M0WUT/p0004-pcb-001_lcd-board/README.md

# P0004-PCB-001 - LCD Board
Front panel board featuring MCU and LCD
