M0WUT/p0004-pcb-001_lcd-board/Schematics/README.md

Use for schematic files other than the top level sheet
