M0WUT/p0004-pcb-001_lcd-board/P0004-PCB-001.kicad_pcb

## KiCad design P0004-PCB-001.kicad_pcb (2026-07-19)

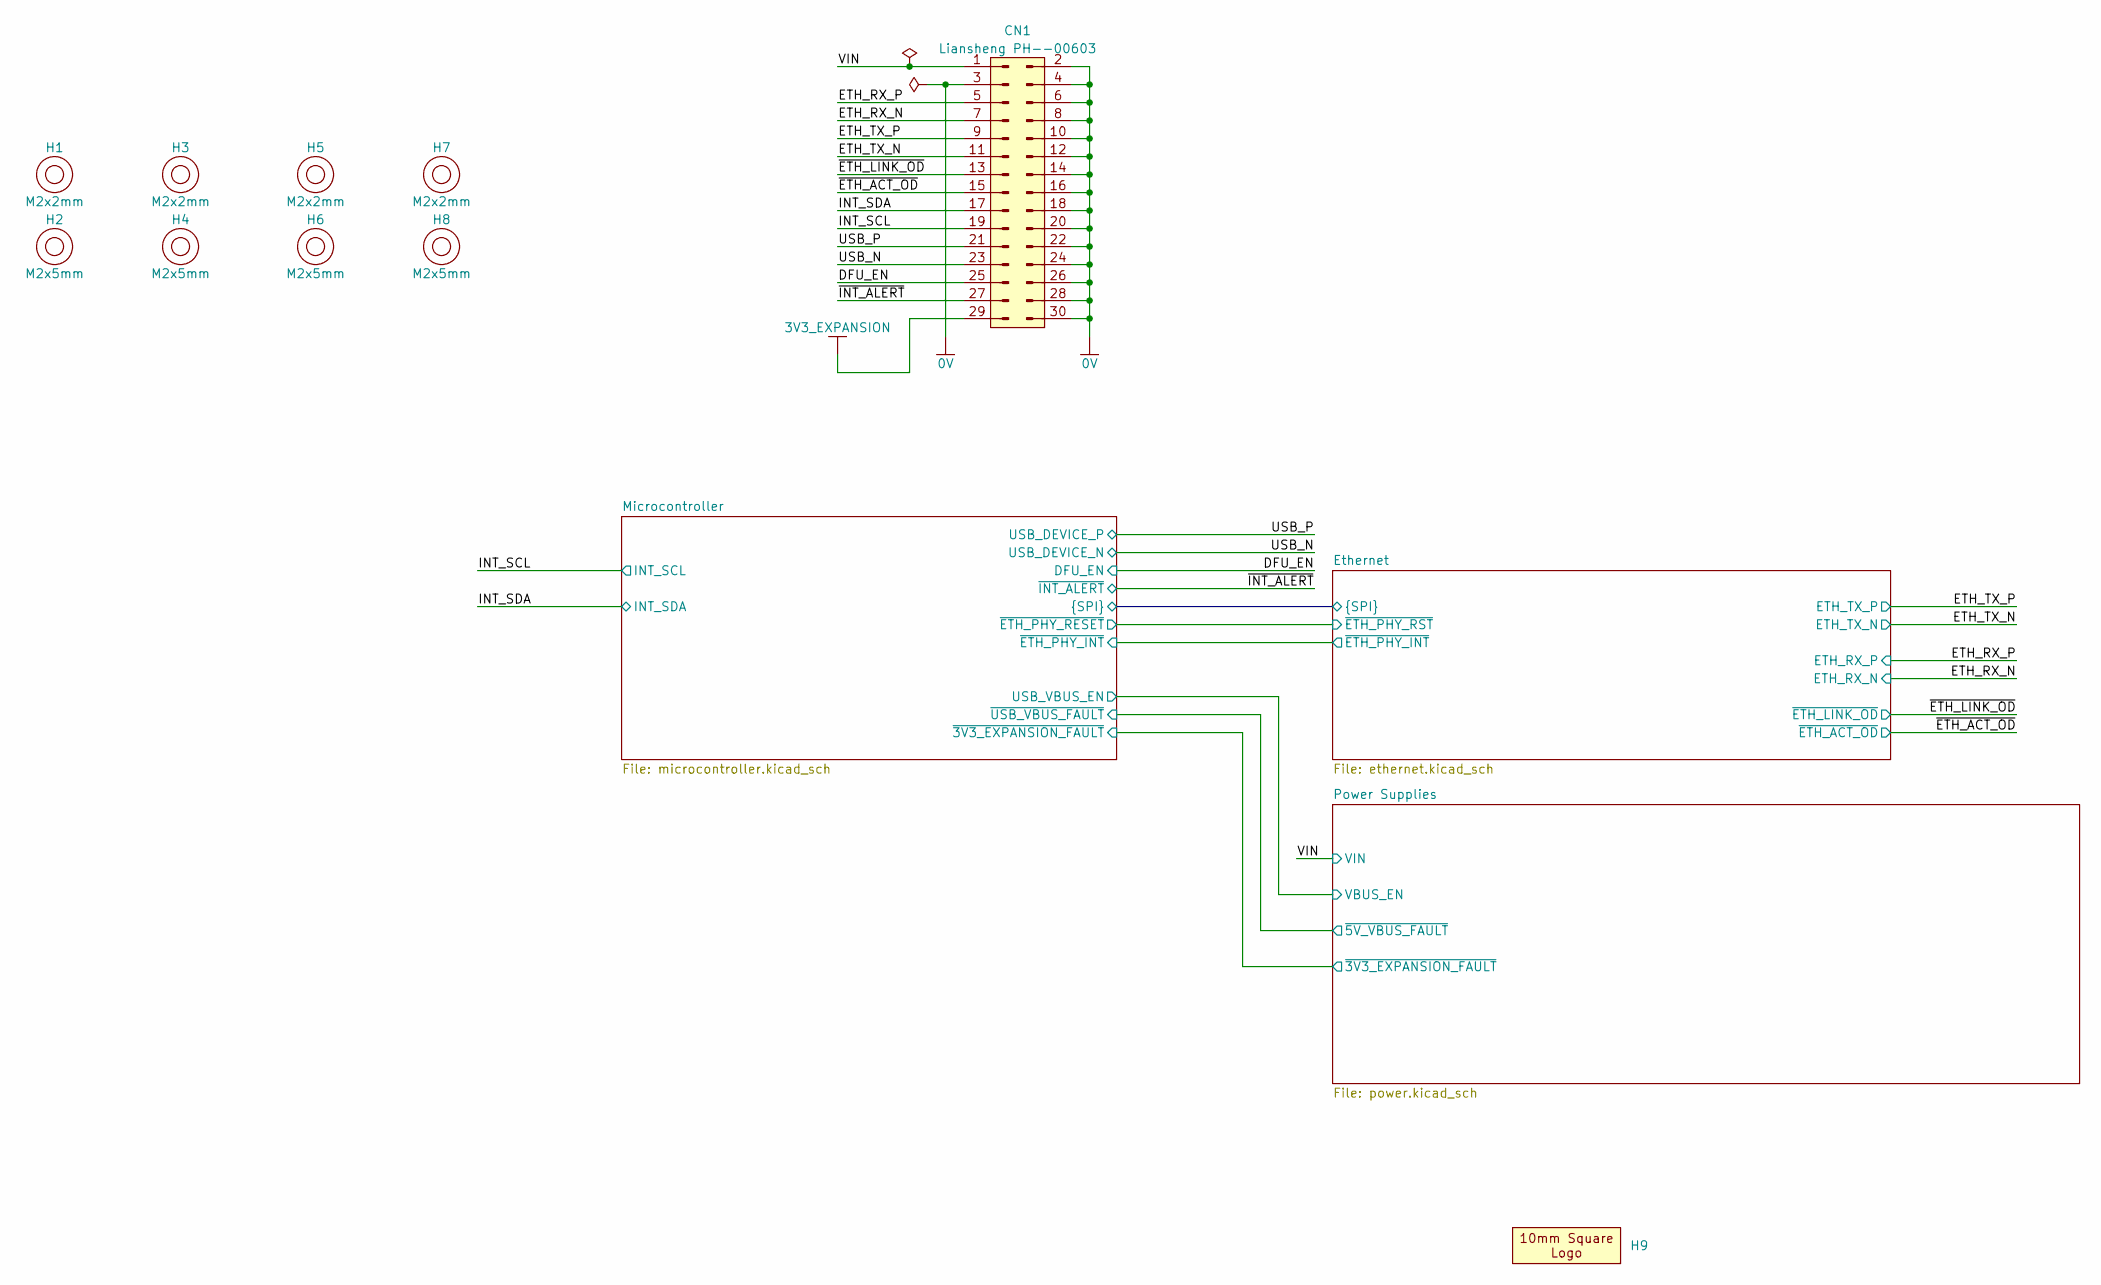
[picture p1: schematic P0004-PCB-001.kicad_sch]

Parts:
CN1: Liansheng PH--00603; Liansheng_PH--00603; MPN PH--00603; JLC Part Number C2685170
H1, H3, H5, H7: M2x2mm; Accu_HPS-4-2.2-2-POM-BL; MPN HPS-4-2.2-2-POM-BL
H2, H4, H6, H8: M2x5mm; Accu_HPS-4-2.2-5-POM-BL; MPN HPS-4-2.2-2-POM-BL
H9: Logo_10mmx10mm

Connections:
0V: CN1.2 (Pin_1), CN1.3, CN1.4, CN1.6, CN1.8, CN1.10, CN1.12, CN1.14, CN1.16, CN1.18, CN1.20, CN1.22, CN1.24, CN1.26, CN1.28, CN1.30; also elsewhere on the board
3V3_EXPANSION: CN1.29; also elsewhere on the board
/DFU_EN: CN1.25; also elsewhere on the board
/ETH_RX_N: CN1.7; also elsewhere on the board
/ETH_RX_P: CN1.5; also elsewhere on the board
/ETH_TX_N: CN1.11; also elsewhere on the board
/ETH_TX_P: CN1.9; also elsewhere on the board
/INT_SCL: CN1.19; also elsewhere on the board
/INT_SDA: CN1.17; also elsewhere on the board
/USB_N: CN1.23; also elsewhere on the board
/USB_P: CN1.21; also elsewhere on the board
/VIN: CN1.1; also elsewhere on the board
/~ETH_ACT_OD: CN1.15; also elsewhere on the board
/~ETH_LINK_OD: CN1.13; also elsewhere on the board
/~INT_ALERT: CN1.27; also elsewhere on the board

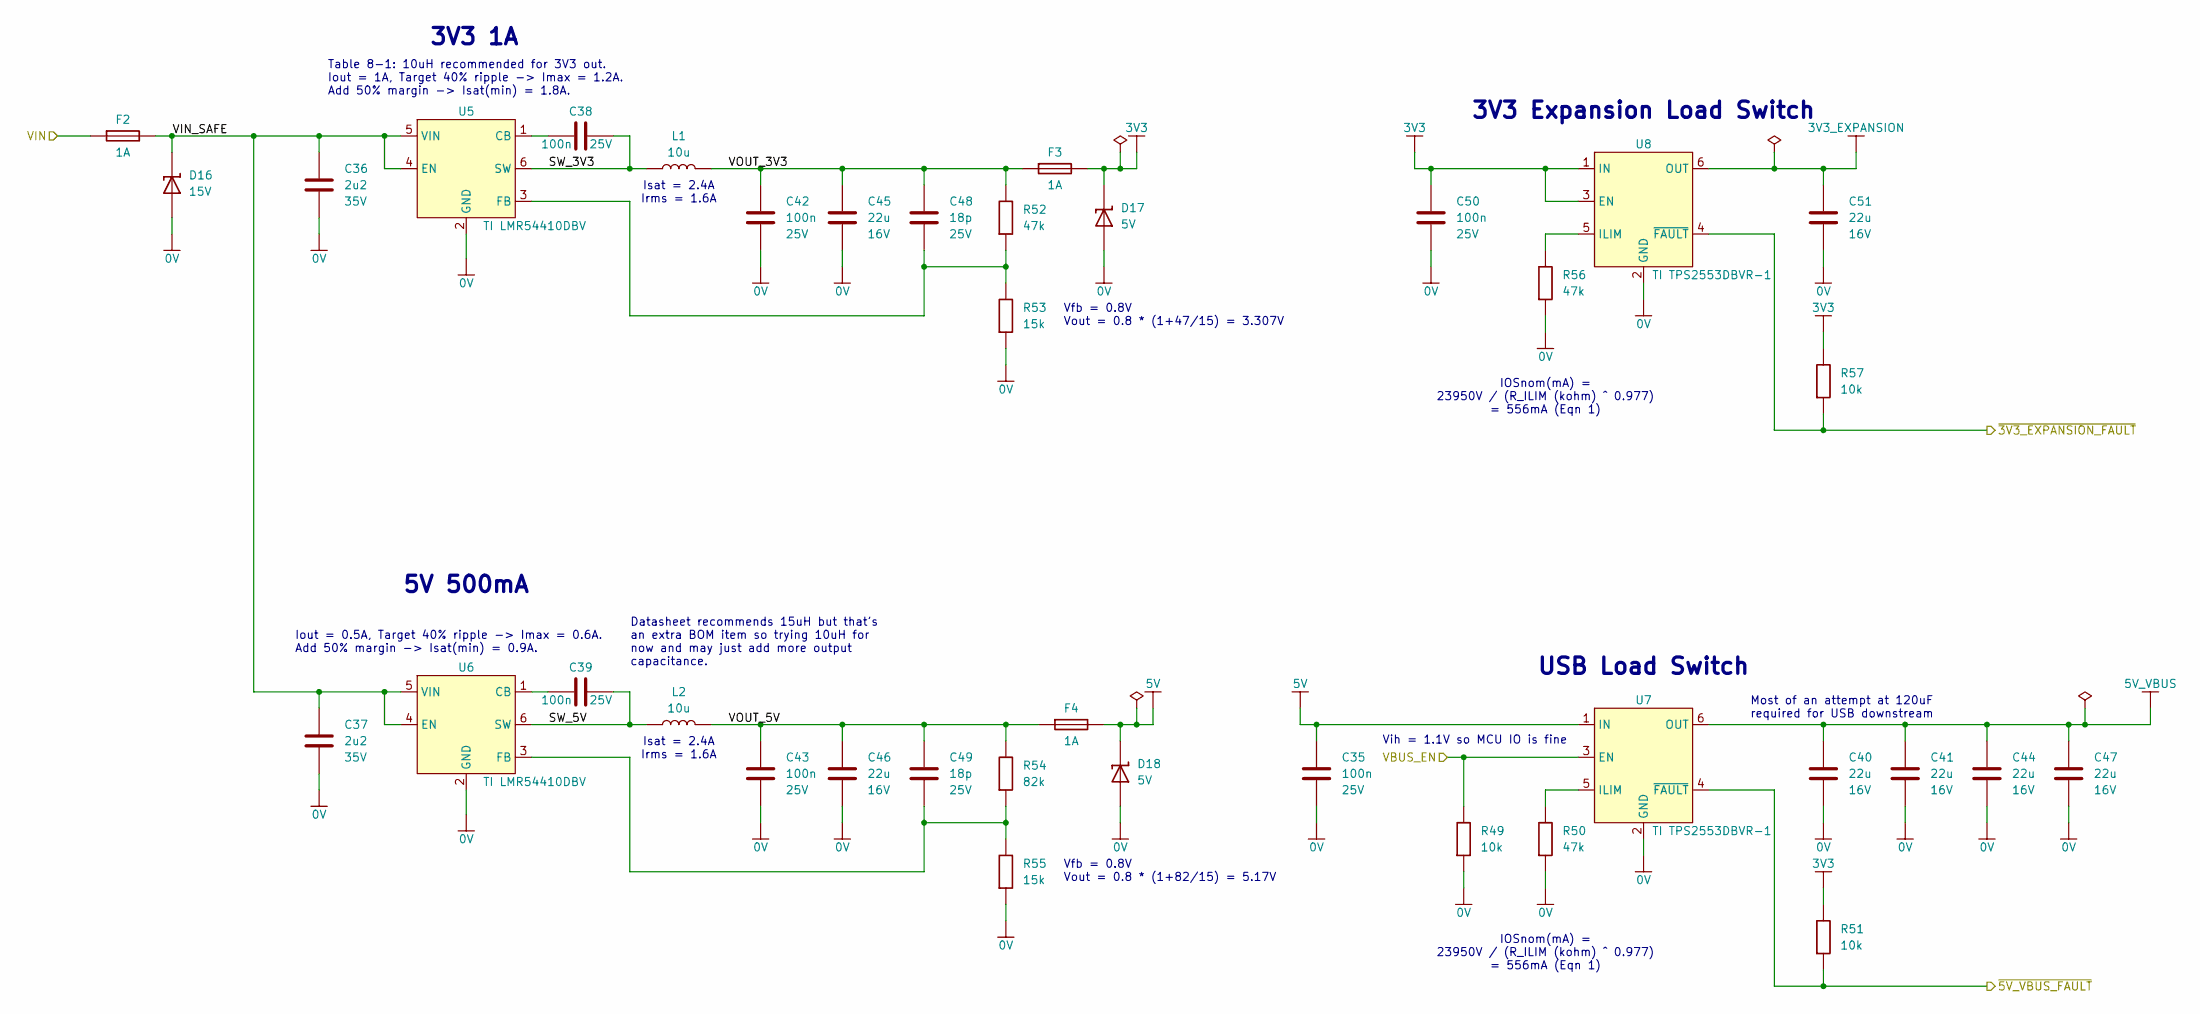
[picture p2: schematic power.kicad_sch]

Parts:
C35, C38, C39, C42, C43, C50: 100n; C_0402_1005Metric; Voltage 25V; Tolerance 10%; MPN CC0402KRX7R8BB104
C36, C37: 2u2; C_0402_1005Metric; Voltage 35V; Tolerance 10%; MPN GRM155R6YA225KE11
C40, C41, C44, C45, C46, C47, C51: 22u; C_0603_1608Metric; Voltage 16V; Tolerance 20%; MPN GRM188R61C226ME01
C48, C49: 18p; C_0402_1005Metric; Voltage 25V; Tolerance 10%; MPN C0402C180K3GACTU
D16: 15V; D_SOD-323; MPN CDSOD-323-T15S
D17, D18: 5V; D_SOD-523; MPN H5VND5U
F2, F3, F4: 1A; Fuse_0603_1608Metric; MPN 0467001.NR
L1, L2: 10u; APV_ANR4030; Tolerance 20%; MPN ANR4030T100M
R49, R51, R57: 10k; R_0402_1005Metric; Tolerance 1%; MPN RK73H1ETTP1002F
R50, R52, R56: 47k; R_0402_1005Metric; Tolerance 1%; MPN RK73H1ETTP4702F
R53, R55: 15k; R_0402_1005Metric; Tolerance 1%; MPN RK73H1ETTP1502F
R54: 82k; R_0402_1005Metric; Tolerance 1%; MPN RK73H1ETTP8202F
U5, U6: TI LMR54410DBV; SOT-23-6; MPN LMR54410DBV; JLCPCB Order # C3200265
U7, U8: TI TPS2553DBVR-1; SOT-23-6; MPN TPS2553DBVR-1; JLCPCB Order # C55266

Connections:
0V: C35.2, C36.2, C37.2, C40.2, C41.2, C42.2, C43.2, C44.2, C45.2, C46.2, C47.2, C50.2, C51.2, D16.2 (A), D17.2 (A), D18.2 (A), R49.2, R50.2, R53.2, R55.2, R56.2, U5.2 (GND), U6.2 (GND), U7.2 (GND), U8.2 (GND); also elsewhere on the board
3V3: C50.1, D17.1 (K), F3.2, R51.1, R57.1, U8.1 (IN), U8.3 (EN); also elsewhere on the board
3V3_EXPANSION: C51.1, U8.6 (OUT); also elsewhere on the board
5V: C35.1, D18.1 (K), F4.2, U7.1 (IN)
5V_VBUS: C40.1, C41.1, C44.1, C47.1, U7.6 (OUT); also elsewhere on the board
/Microcontroller/USB_VBUS_EN: R49.1, U7.3 (EN); also elsewhere on the board
/Microcontroller/~3V3_EXPANSION_FAULT: R57.2, U8.4 (~FAULT); also elsewhere on the board
/Microcontroller/~USB_VBUS_FAULT: R51.2, U7.4 (~FAULT); also elsewhere on the board
/Power Supplies/SW_3V3: C38.1, L1.1, U5.6 (SW)
/Power Supplies/SW_5V: C39.1, L2.1, U6.6 (SW)
/Power Supplies/VIN_SAFE: C36.1, C37.1, D16.1 (K), F2.2, U5.4 (EN), U5.5 (VIN), U6.4 (EN), U6.5 (VIN)
/Power Supplies/VOUT_3V3: C42.1, C45.1, C48.1, F3.1, L1.2, R52.1
/Power Supplies/VOUT_5V: C43.1, C46.1, C49.1, F4.1, L2.2, R54.1
/VIN: F2.1; also elsewhere on the board
unnamed: C38.2, U5.1 (CB)
unnamed: C48.2, R52.2, R53.1, U5.3 (FB)
unnamed: C39.2, U6.1 (CB)
unnamed: C49.2, R54.2, R55.1, U6.3 (FB)
unnamed: R50.1, U7.5 (ILIM)
unnamed: R56.1, U8.5 (ILIM)

Notes on the sheet:
3V3 1A
Isat = 2.4A Irms = 1.6A
IOSnom(mA) = 23950V / (R_ILIM (kohm) ^ 0.977) = 556mA (Eqn 1)
Vfb = 0.8V Vout = 0.8 * (1+82/15) = 5.17V
Vih = 1.1V so MCU IO is fine
Table 8-1: 10uH recommended for 3V3 out. Iout = 1A, Target 40% ripple -> Imax = 1.2A. Add 50% margin -> Isat(min) = 1.8A.
USB Load Switch
Most of an attempt at 120uF required for USB downstream
3V3 Expansion Load Switch
Vfb = 0.8V Vout = 0.8 * (1+47/15) = 3.307V
5V 500mA
Datasheet recommends 15uH but that's an extra BOM item so trying 10uH for now and may just add more output capacitance.
Iout = 0.5A, Target 40% ripple -> Imax = 0.6A. Add 50% margin -> Isat(min) = 0.9A.

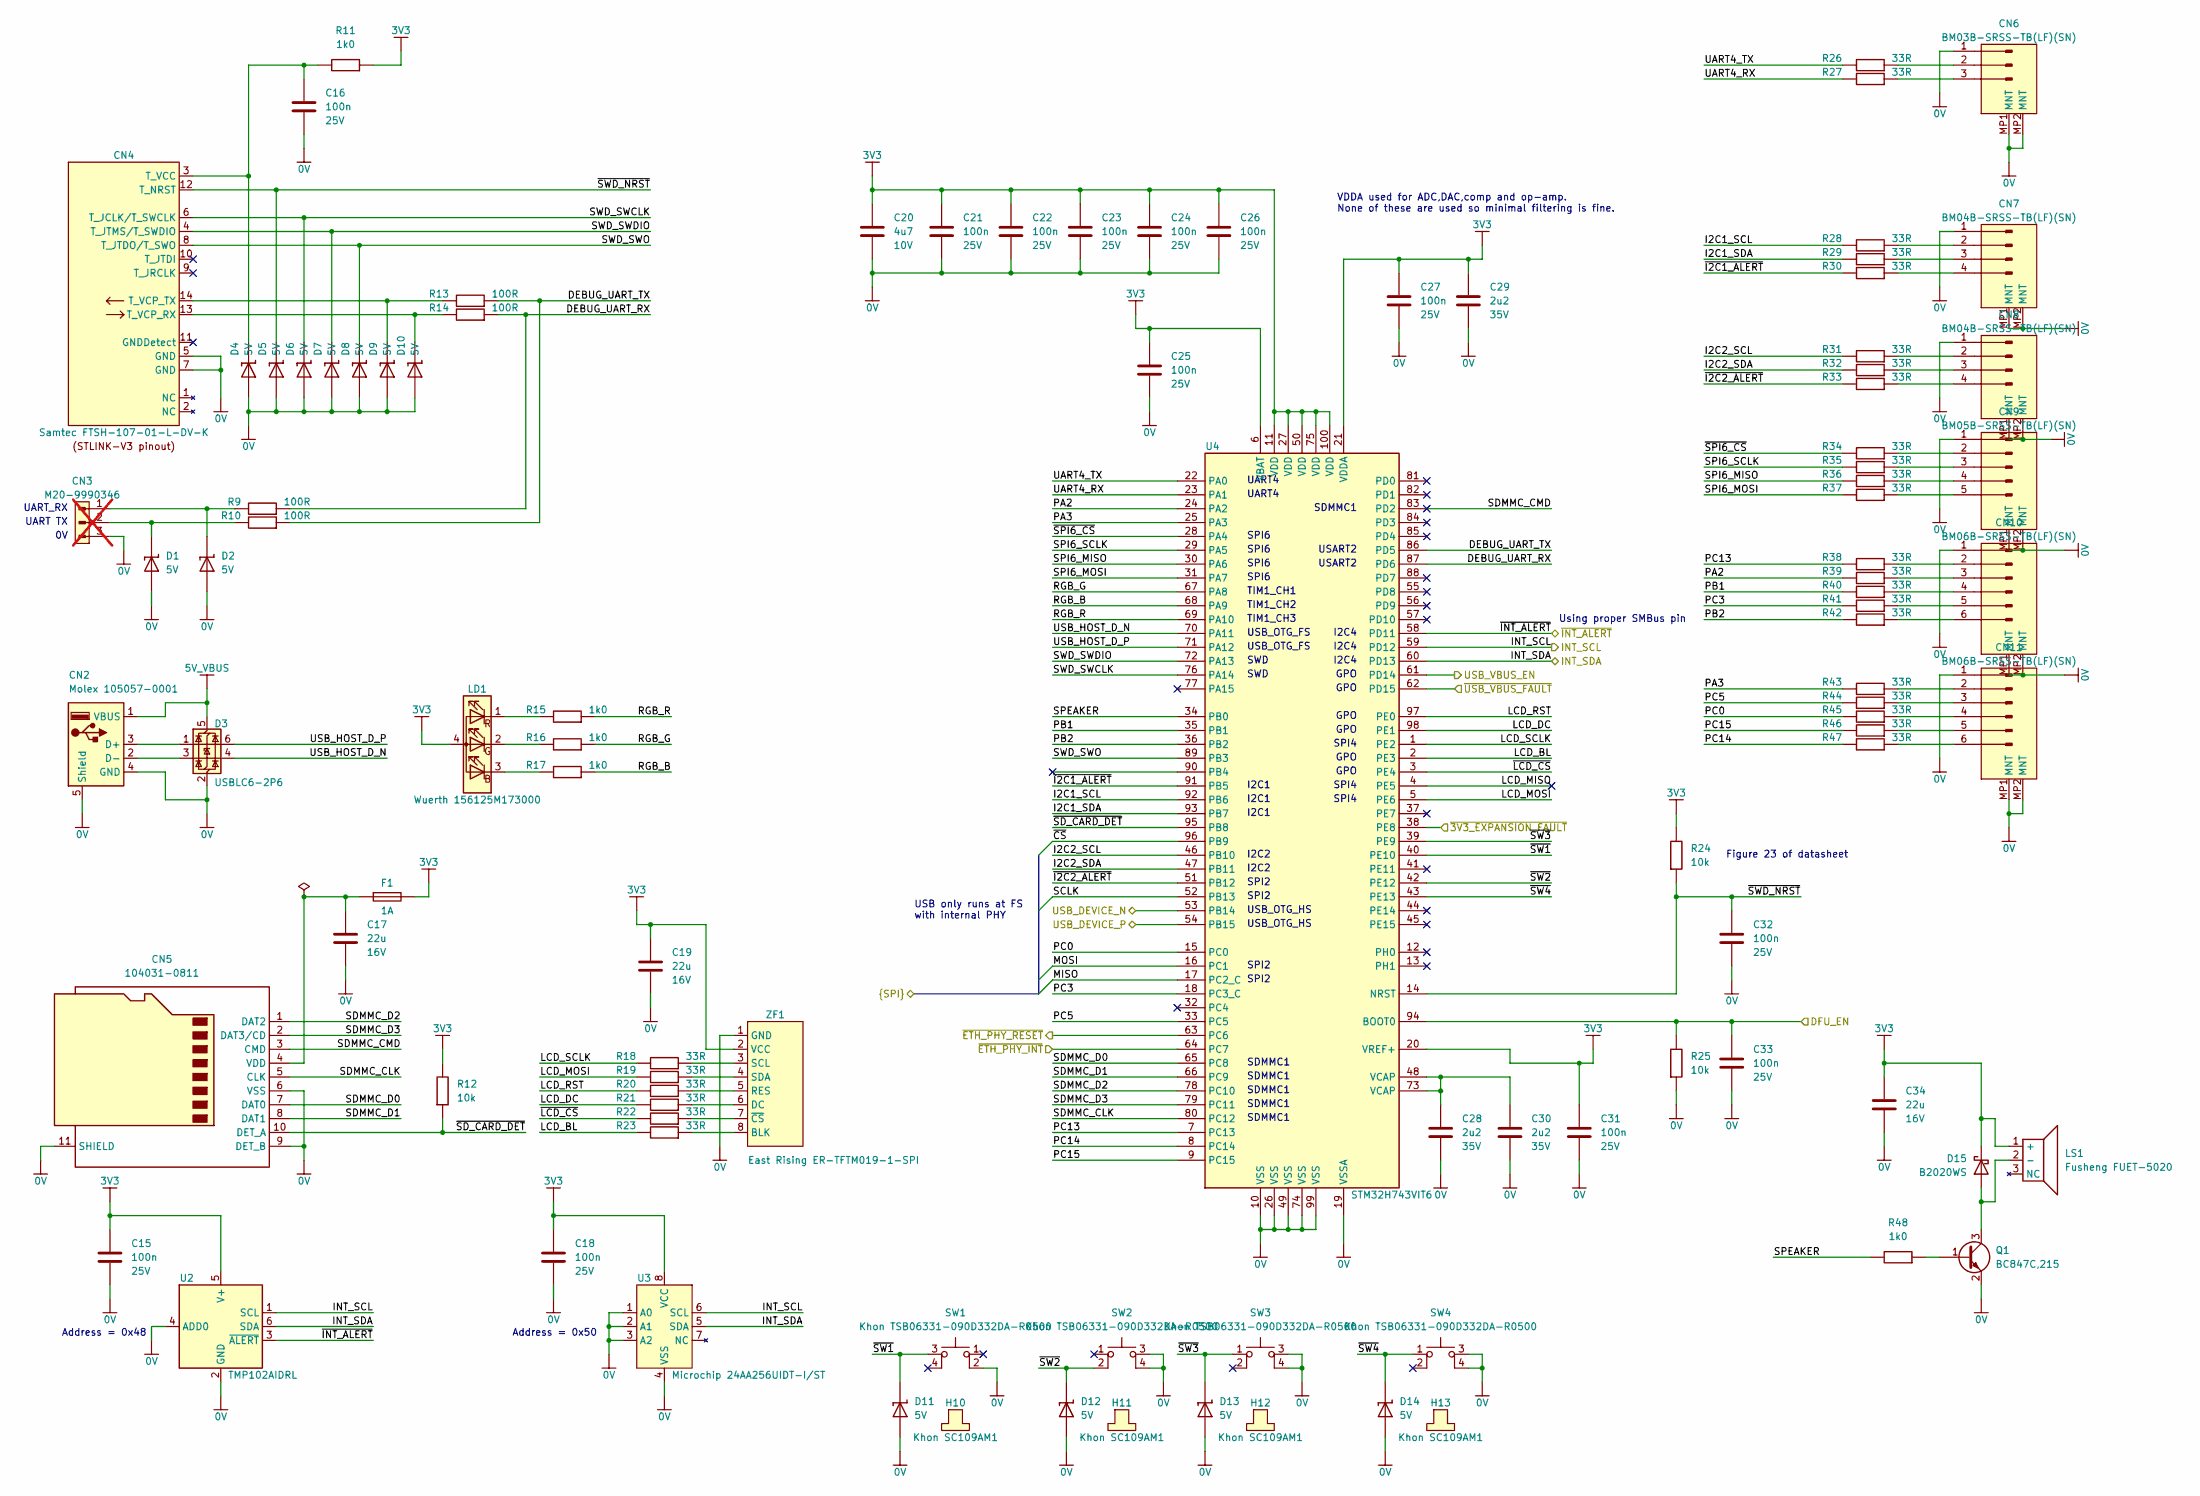
[picture p3: schematic microcontroller.kicad_sch]

Parts:
C15, C16, C18, C21, C22, C23, C24, C25, C26, C27, C31, C32, C33: 100n; C_0402_1005Metric; Voltage 25V; Tolerance 10%; MPN CC0402KRX7R8BB104
C17, C19, C34: 22u; C_0603_1608Metric; Voltage 16V; Tolerance 20%; MPN GRM188R61C226ME01
C20: 4u7; C_0402_1005Metric; Voltage 10V; Tolerance 20%; MPN GRM155D71A475ME15
C28, C29, C30: 2u2; C_0402_1005Metric; Voltage 35V; Tolerance 10%; MPN GRM155R6YA225KE11
CN2: Molex 105057-0001; USB-A_Molex_105057-0001_TH_Vertical; MPN 105057-0001
CN3: M20-9990346; MPN M20-9990346; JLCPCB Order # C5355646; not fitted
CN4: Samtec FTSH-107-01-L-DV-K; Header_Samtec_FTSH-107-01-L-DV-K; MPN FTSH-107-01-L-DV-K; JLCPCB Order # C5307809
CN5: 104031-0811; microSD_HC_Molex_104031-0811; MPN 104031-0811
CN6: BM03B-SRSS-TB(LF)(SN); BM03B-SRSS-TB; MPN BM03B-SRSS-TB(LF)(SN); JLCPCB Order # C160389
CN7, CN8: BM04B-SRSS-TB(LF)(SN); BM04B-SRSS-TB; MPN BM04B-SRSS-TB(LF)(SN); JLCPCB Order # C160390
CN9: BM05B-SRSS-TB(LF)(SN); BM05B-SRSS-TB; MPN BM05B-SRSS-TB(LF)(SN); JLCPCB Order # C160391
CN10, CN11: BM06B-SRSS-TB(LF)(SN); BM06B-SRSS-TB; MPN BM06B-SRSS-TB(LF)(SN); JLCPCB Order # C160392
D1, D2, D4, D5, D6, D7, D8, D9, D10, D11, D12, D13, D14: 5V; D_SOD-523; MPN H5VND5U
D3: USBLC6-2P6; SOT-666; MPN USBLC6-2P6
D15: B2020WS; D_SOD-323; MPN B2020WS
F1: 1A; Fuse_0603_1608Metric; MPN 0467001.NR
H10, H11, H12, H13: Khon SC109AM1; Khon_SC109; MPN SC109AM1; JLCPCB Order # C42435457
LD1: Wuerth 156125M173000; Wuerth_156125M173000; MPN 156125M173000; JLCPCB Order # C5341671
LS1: Fusheng FUET-5020; Fusheng_FUET-5020; MPN FUET-5020; JLCPCB Order # C391029
Q1: BC847C,215; SOT-23; MPN BC847C,215; JLCPCB Order # C8664
R9, R10, R13, R14: 100R; R_0402_1005Metric; Tolerance 1%; MPN RK73H1ETTP1000F
R11, R15, R16, R17, R48: 1k0; R_0402_1005Metric; Tolerance 1%; MPN RK73H1ETTP1001F
R12, R24, R25: 10k; R_0402_1005Metric; Tolerance 1%; MPN RK73H1ETTP1002F
R18, R19, R20, R21, R22, R23, R26, R27, R28, R29, R30, R31, R32, R33, R34, R35, R36, R37, R38, R39, R40, R41, R42, R43, R44, R45, R46, R47: 33R; R_0402_1005Metric; Tolerance 1%; MPN RK73H1ETTP33R0F
SW1, SW2, SW3, SW4: Khon TSB06331-090D332DA-R0500; Khon_TSB06331-090; MPN TSB06331-090D332DA-R0500
U2: TMP102AIDRL; SOT-563; MPN TMP102AIDRL; JLCPCB Order # C99269
U3: Microchip 24AA256UIDT-I/ST; TSSOP-8_4.4x3mm_P0.65mm; MPN 24AA256UIDT-I/ST; JLCPCB Order # C619926
U4: STM32H743VIT6; LQFP-100_14x14mm_P0.5mm; MPN STM32H743VIT6; JLCPCB Part # C114409
ZF1: East Rising ER-TFTM019-1-SPI; East-Rising_ER-TFTM019-1-SPI; MPN ER-TFTM019-1-SPI

Connections:
0V: C15.2, C16.2, C17.2, C18.2, C19.2, C20.2, C21.2, C22.2, C23.2, C24.2, C25.2, C26.2, C27.2, C28.2, C29.2, C30.2, C31.2, C32.2, C33.2, C34.2, CN2.4 (GND), CN2.5 (Shield), CN3.3, CN4.5 (GND), CN4.7 (GND), CN5.6 (VSS), CN5.9 (DET_B), CN5.11 (SHIELD), CN6.1, CN6.MP1 (MNT), CN6.MP2 (MNT), CN7.1, CN7.MP1 (MNT), CN7.MP2 (MNT), CN8.1, CN8.MP1 (MNT), CN8.MP2 (MNT), CN9.1, CN9.MP1 (MNT), CN9.MP2 (MNT), CN10.1, CN10.MP1 (MNT), CN10.MP2 (MNT), CN11.1, CN11.MP1 (MNT), CN11.MP2 (MNT), D1.2 (A), D2.2 (A), D3.2 (GND), D4.2 (A), D5.2 (A), D6.2 (A), D7.2 (A), D8.2 (A), D9.2 (A), D10.2 (A), D11.2 (A), D12.2 (A), D13.2 (A), D14.2 (A), Q1.2 (E), R25.2, SW1.2, SW2.3, SW2.4, SW3.3, SW3.4, SW4.3, SW4.4, U2.2 (GND), U2.4 (ADD0), U3.1 (A0), U3.2 (A1), U3.3 (A2), U3.4 (VSS), U4.10 (VSS), U4.19 (VSSA), U4.26 (VSS), U4.49 (VSS), U4.74 (VSS), U4.99 (VSS), ZF1.1 (GND); also elsewhere on the board
3V3: C15.1, C18.1, C19.1, C20.1, C21.1, C22.1, C23.1, C24.1, C25.1, C26.1, C27.1, C29.1, C31.1, C34.1, D15.1 (K), F1.2, LD1.4 (A), LS1.1 (+), R11.2, R12.1, R24.1, U2.5 (V+), U3.8 (VCC), U4.6 (VBAT), U4.11 (VDD), U4.20 (VREF+), U4.21 (VDDA), U4.27 (VDD), U4.50 (VDD), U4.75 (VDD), U4.100 (VDD), ZF1.2 (VCC); also elsewhere on the board
5V_VBUS: CN2.1 (VBUS), D3.5 (VBUS); also elsewhere on the board
/DFU_EN: C33.1, R25.1, U4.94 (BOOT0); also elsewhere on the board
/Ethernet/MISO: U4.17 (PC2_C); also elsewhere on the board
/Ethernet/MOSI: U4.16 (PC1); also elsewhere on the board
/Ethernet/SCLK: U4.52 (PB13); also elsewhere on the board
/Ethernet/~CS: U4.96 (PB9); also elsewhere on the board
/Ethernet/~ETH_PHY_INT: U4.64 (PC7); also elsewhere on the board
/Ethernet/~ETH_PHY_RST: U4.63 (PC6); also elsewhere on the board
/INT_SCL: U2.1 (SCL), U3.6 (SCL), U4.59 (PD12); also elsewhere on the board
/INT_SDA: U2.6 (SDA), U3.5 (SDA), U4.60 (PD13); also elsewhere on the board
/Microcontroller/DEBUG_UART_RX: R9.2, R14.2, U4.87 (PD6)
/Microcontroller/DEBUG_UART_TX: R10.2, R13.2, U4.86 (PD5)
/Microcontroller/I2C1_SCL: R28.1, U4.92 (PB6)
/Microcontroller/I2C1_SDA: R29.1, U4.93 (PB7)
/Microcontroller/I2C2_SCL: R31.1, U4.46 (PB10)
/Microcontroller/I2C2_SDA: R32.1, U4.47 (PB11)
/Microcontroller/LCD_BL: R23.1, U4.2 (PE3)
/Microcontroller/LCD_DC: R21.1, U4.98 (PE1)
/Microcontroller/LCD_MISO: U4.4 (PE5)
/Microcontroller/LCD_MOSI: R19.1, U4.5 (PE6)
/Microcontroller/LCD_RST: R20.1, U4.97 (PE0)
/Microcontroller/LCD_SCLK: R18.1, U4.1 (PE2)
/Microcontroller/PA2: R39.1, U4.24 (PA2)
/Microcontroller/PA3: R43.1, U4.25 (PA3)
/Microcontroller/PB1: R40.1, U4.35 (PB1)
/Microcontroller/PB2: R42.1, U4.36 (PB2)
/Microcontroller/PC0: R45.1, U4.15 (PC0)
/Microcontroller/PC3: R41.1, U4.18 (PC3_C)
/Microcontroller/PC5: R44.1, U4.33 (PC5)
/Microcontroller/PC13: R38.1, U4.7 (PC13)
/Microcontroller/PC14: R47.1, U4.8 (PC14)
/Microcontroller/PC15: R46.1, U4.9 (PC15)
/Microcontroller/RGB_B: R17.2, U4.68 (PA9)
/Microcontroller/RGB_G: R16.2, U4.67 (PA8)
/Microcontroller/RGB_R: R15.2, U4.69 (PA10)
/Microcontroller/SDMMC_CLK: CN5.5 (CLK), U4.80 (PC12)
/Microcontroller/SDMMC_CMD: CN5.3 (CMD), U4.83 (PD2)
/Microcontroller/SDMMC_D0: CN5.7 (DAT0), U4.65 (PC8)
/Microcontroller/SDMMC_D1: CN5.8 (DAT1), U4.66 (PC9)
/Microcontroller/SDMMC_D2: CN5.1 (DAT2), U4.78 (PC10)
/Microcontroller/SDMMC_D3: CN5.2 (DAT3/CD), U4.79 (PC11)
/Microcontroller/SPEAKER: R48.1, U4.34 (PB0)
/Microcontroller/SPI6_MISO: R36.1, U4.30 (PA6)
/Microcontroller/SPI6_MOSI: R37.1, U4.31 (PA7)
/Microcontroller/SPI6_SCLK: R35.1, U4.29 (PA5)
/Microcontroller/SWD_SWCLK: CN4.6 (T_JCLK/T_SWCLK), D6.1 (K), U4.76 (PA14)
/Microcontroller/SWD_SWDIO: CN4.4 (T_JTMS/T_SWDIO), D7.1 (K), U4.72 (PA13)
/Microcontroller/SWD_SWO: CN4.8 (T_JTDO/T_SWO), D8.1 (K), U4.89 (PB3)
/Microcontroller/UART4_RX: R27.1, U4.23 (PA1)
/Microcontroller/UART4_TX: R26.1, U4.22 (PA0)
/Microcontroller/USB_HOST_D_N: D3.4 (I/O2), U4.70 (PA11)
/Microcontroller/USB_HOST_D_P: D3.6 (I/O1), U4.71 (PA12)
/Microcontroller/USB_VBUS_EN: U4.61 (PD14); also elsewhere on the board
/Microcontroller/~3V3_EXPANSION_FAULT: U4.38 (PE8); also elsewhere on the board
/Microcontroller/~I2C1_ALERT: R30.1, U4.91 (PB5)
/Microcontroller/~I2C2_ALERT: R33.1, U4.51 (PB12)
/Microcontroller/~LCD_CS: R22.1, U4.3 (PE4)
/Microcontroller/~SD_CARD_DET: CN5.10 (DET_A), R12.2, U4.95 (PB8)
/Microcontroller/~SPI6_CS: R34.1, U4.28 (PA4)
/Microcontroller/~SW1: D11.1 (K), SW1.3, U4.40 (PE10)
/Microcontroller/~SW2: D12.1 (K), SW2.2, U4.42 (PE12)
/Microcontroller/~SW3: D13.1 (K), SW3.1, U4.39 (PE9)
/Microcontroller/~SW4: D14.1 (K), SW4.1, U4.43 (PE13)
/Microcontroller/~SWD_NRST: C32.1, CN4.12 (T_NRST), D5.1 (K), R24.2, U4.14 (NRST)
/Microcontroller/~USB_VBUS_FAULT: U4.62 (PD15); also elsewhere on the board
/USB_N: U4.53 (PB14); also elsewhere on the board
/USB_P: U4.54 (PB15); also elsewhere on the board
/~INT_ALERT: U2.3 (~ALERT), U4.58 (PD11); also elsewhere on the board
unnamed: C28.1, C30.1, U4.48 (VCAP), U4.73 (VCAP)
unnamed: CN2.3 (D+), D3.1 (I/O1)
unnamed: CN2.2 (D-), D3.3 (I/O2)
unnamed: C16.1, CN4.3 (T_VCC), D4.1 (K), R11.1
unnamed: CN4.13 (T_VCP_RX), D10.1 (K), R14.1
unnamed: CN4.14 (T_VCP_TX), D9.1 (K), R13.1
unnamed: C17.1, CN5.4 (VDD), F1.1
unnamed: CN6.2, R26.2
unnamed: CN6.3, R27.2
unnamed: CN7.2, R28.2
unnamed: CN7.3, R29.2
unnamed: CN7.4, R30.2
unnamed: CN8.2, R31.2
unnamed: CN8.3, R32.2
unnamed: CN8.4, R33.2
unnamed: CN9.2, R34.2
unnamed: CN9.3, R35.2
unnamed: CN9.4, R36.2
unnamed: CN9.5, R37.2
unnamed: CN10.2, R38.2
unnamed: CN10.3, R39.2
unnamed: CN10.4, R40.2
unnamed: CN10.5, R41.2
unnamed: CN10.6, R42.2
unnamed: CN11.2, R43.2
unnamed: CN11.3, R44.2
unnamed: CN11.4, R45.2
unnamed: CN11.5, R46.2
unnamed: CN11.6, R47.2
unnamed: CN3.2, D1.1 (K), R10.1
unnamed: CN3.1, D2.1 (K), R9.1
unnamed: D15.2 (A), LS1.2 (-), Q1.3 (C)
unnamed: LD1.3 (B), R17.1
unnamed: LD1.2 (G), R16.1
unnamed: LD1.1 (R), R15.1
unnamed: Q1.1 (B), R48.2
unnamed: R23.2, ZF1.8 (BLK)
unnamed: R21.2, ZF1.6 (DC)
unnamed: R20.2, ZF1.5 (RES)
unnamed: R18.2, ZF1.3 (SCL)
unnamed: R19.2, ZF1.4 (SDA)
unnamed: R22.2, ZF1.7 (~CS)

Notes on the sheet:
GPO
SDMMC1
SWD
I2C4
TIM1_CH3
VDDA used for ADC,DAC,comp and op-amp. None of these are used so minimal filtering is fine.
USB_OTG_FS
USB only runs at FS with internal PHY
SPI4
SPI6
SPI2
Figure 23 of datasheet
USB_OTG_HS
I2C1
UART TX
USART2
TIM1_CH2
Address = 0x50
UART_RX
Using proper SMBus pin
Address = 0x48
I2C2
TIM1_CH1
UART4

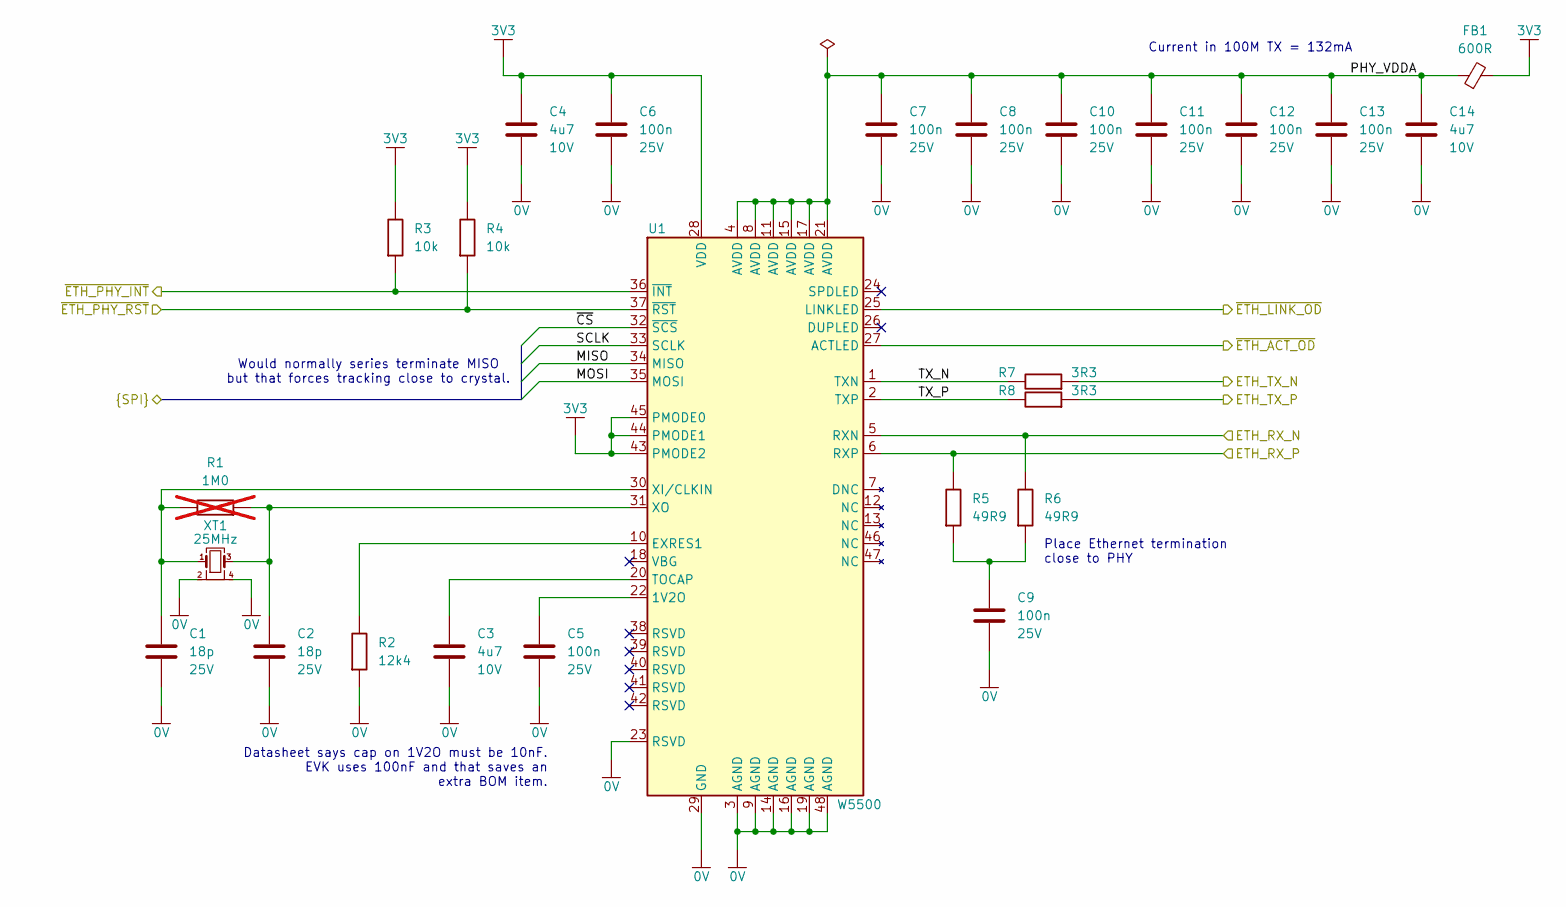
[picture p4: schematic ethernet.kicad_sch]

Parts:
C1, C2: 18p; C_0402_1005Metric; Voltage 25V; Tolerance 10%; MPN C0402C180K3GACTU
C3, C4, C14: 4u7; C_0402_1005Metric; Voltage 10V; Tolerance 20%; MPN GRM155D71A475ME15
C5, C6, C7, C8, C9, C10, C11, C12, C13: 100n; C_0402_1005Metric; Voltage 25V; Tolerance 10%; MPN CC0402KRX7R8BB104
FB1: 600R; L_0603_1608Metric; MPN BLM18AG601SN1D
R1: 1M0; R_0402_1005Metric; Tolerance 1%; MPN RK73H1ETTP1004F; not fitted
R2: 12k4; R_0402_1005Metric; Tolerance 1%; MPN RK73H1ETTP1242F
R3, R4: 10k; R_0402_1005Metric; Tolerance 1%; MPN RK73H1ETTP1002F
R5, R6: 49R9; R_0402_1005Metric; Tolerance 1%; MPN RK73H1ETTP49R9F
R7, R8: 3R3; R_0402_1005Metric; Tolerance 1%; MPN RK73H1ETTP3R30F
U1: W5500; LQFP-48_7x7mm_P0.5mm; MPN W5500; JLCPCB Order # C32843
XT1: 25MHz; Murata_XRCGB; MPN XRCGB25M000F3M18R0; JLCPCB Order # C1986195

Connections:
0V: C1.2, C2.2, C3.2, C4.2, C5.2, C6.2, C7.2, C8.2, C9.2, C10.2, C11.2, C12.2, C13.2, C14.2, R2.2, U1.3 (AGND), U1.9 (AGND), U1.14 (AGND), U1.16 (AGND), U1.19 (AGND), U1.23 (RSVD), U1.29 (GND), U1.48 (AGND), XT1.2, XT1.4; also elsewhere on the board
3V3: C4.1, C6.1, FB1.2, R3.1, R4.1, U1.28 (VDD), U1.43 (PMODE2), U1.44 (PMODE1), U1.45 (PMODE0); also elsewhere on the board
/ETH_RX_N: R6.1, U1.5 (RXN); also elsewhere on the board
/ETH_RX_P: R5.1, U1.6 (RXP); also elsewhere on the board
/ETH_TX_N: R7.2; also elsewhere on the board
/ETH_TX_P: R8.2; also elsewhere on the board
/Ethernet/MISO: U1.34 (MISO); also elsewhere on the board
/Ethernet/MOSI: U1.35 (MOSI); also elsewhere on the board
/Ethernet/PHY_VDDA: C7.1, C8.1, C10.1, C11.1, C12.1, C13.1, C14.1, FB1.1, U1.4 (AVDD), U1.8 (AVDD), U1.11 (AVDD), U1.15 (AVDD), U1.17 (AVDD), U1.21 (AVDD)
/Ethernet/SCLK: U1.33 (SCLK); also elsewhere on the board
/Ethernet/TX_N: R7.1, U1.1 (TXN)
/Ethernet/TX_P: R8.1, U1.2 (TXP)
/Ethernet/~CS: U1.32 (~SCS); also elsewhere on the board
/Ethernet/~ETH_PHY_INT: R3.2, U1.36 (~INT); also elsewhere on the board
/Ethernet/~ETH_PHY_RST: R4.2, U1.37 (~RST); also elsewhere on the board
/~ETH_ACT_OD: U1.27 (ACTLED); also elsewhere on the board
/~ETH_LINK_OD: U1.25 (LINKLED); also elsewhere on the board
unnamed: C9.1, R5.2, R6.2
unnamed: C5.1, U1.22 (1V2O)
unnamed: R2.1, U1.10 (EXRES1)
unnamed: C3.1, U1.20 (TOCAP)
unnamed: C1.1, R1.1, U1.30 (XI/CLKIN), XT1.1
unnamed: C2.1, R1.2, U1.31 (XO), XT1.3

Notes on the sheet:
Current in 100M TX = 132mA
Would normally series terminate MISO but that forces tracking close to crystal.
Place Ethernet termination close to PHY
Datasheet says cap on 1V2O must be 10nF. EVK uses 100nF and that saves an extra BOM item.

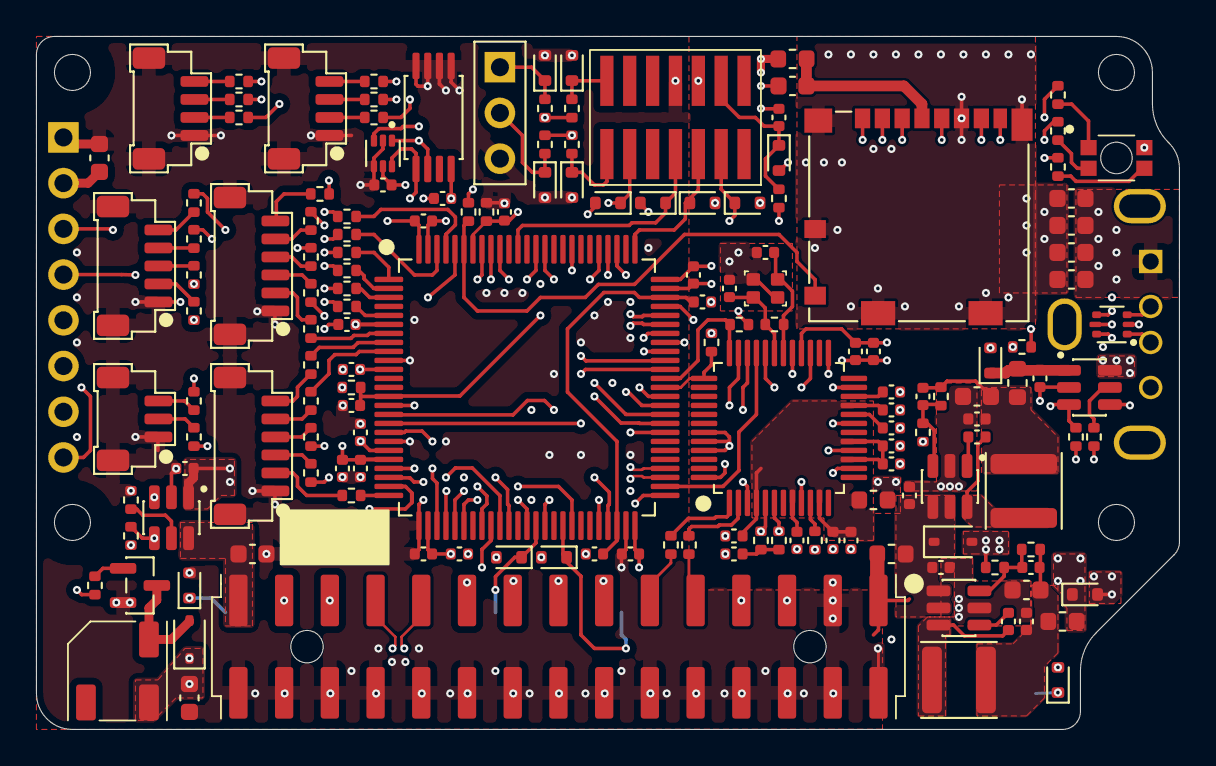
[picture p5: board P0004-PCB-001.kicad_pcb from above]

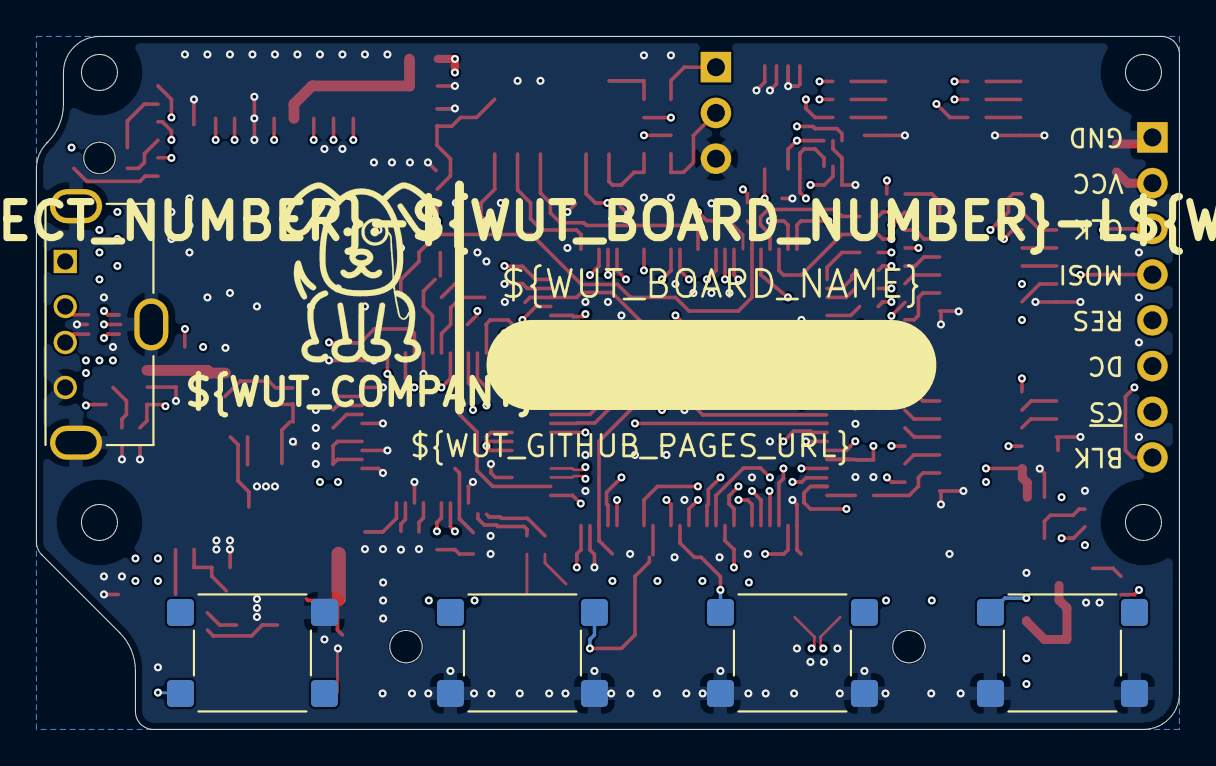
[picture p6: board P0004-PCB-001.kicad_pcb from below]

Board: 6 copper layers, 63.5 x 38.5 mm, 174 parts (19 on the bottom side), 140 nets.
