M0WUT/p0004-pcb-001_lcd-board/(commit log)

2026-06-06 Argonaut: Created
    [P0004-PCB-001.kicad_pcb, P0004-PCB-001.kicad_sch]
2026-06-06 started adding components
    [P0004-PCB-001.kicad_pcb, P0004-PCB-001.kicad_sch, ethernet.kicad_sch, microcontroller.kicad_sch]
2026-06-07 testing ci config
    [P0004-PCB-001.kicad_pcb, P0004-PCB-001.kicad_sch]
2026-06-07 started on DCDC section
    [P0004-PCB-001.kicad_pcb, P0004-PCB-001.kicad_sch, microcontroller.kicad_sch, power.kicad_sch]
2026-06-08 added ethernet phy
    [P0004-PCB-001.kicad_pcb, P0004-PCB-001.kicad_sch, ethernet.kicad_sch, microcontroller.kicad_sch, power.kicad_sch]
2026-06-09 started on mcu pinout
    [P0004-PCB-001.kicad_pcb, ethernet.kicad_sch, microcontroller.kicad_sch, power.kicad_sch]
2026-06-12 layout progress
    [P0004-PCB-001.kicad_pcb, P0004-PCB-001.kicad_sch, power.kicad_sch]
2026-06-13 added 5v regulator
    [P0004-PCB-001.kicad_pcb, power.kicad_sch]
2026-06-14 helps if you save first
    [P0004-PCB-001.kicad_pcb]
2026-06-17 did a few little bits on layout
    [P0004-PCB-001.kicad_pcb, P0004-PCB-001.kicad_sch, power.kicad_sch]
2026-06-18 more progress
    [P0004-PCB-001.kicad_pcb, P0004-PCB-001.kicad_sch, ethernet.kicad_sch, microcontroller.kicad_sch, power.kicad_sch]
2026-06-20 most things connected
    [P0004-PCB-001.kicad_pcb, P0004-PCB-001.kicad_sch, microcontroller.kicad_sch]
2026-06-21 headers now connected
    [P0004-PCB-001.kicad_pcb, microcontroller.kicad_sch]
2026-07-05 just need last tidy up
    [P0004-PCB-001.kicad_pcb, P0004-PCB-001.kicad_sch, ethernet.kicad_sch, microcontroller.kicad_sch, power.kicad_sch]
2026-07-10 component tidy up
    [P0004-PCB-001.kicad_pcb, P0004-PCB-001.kicad_sch, ethernet.kicad_sch, microcontroller.kicad_sch, power.kicad_sch]
2026-07-17 added tidied up library symbols
    [P0004-PCB-001.kicad_pcb, P0004-PCB-001.kicad_sch, ethernet.kicad_sch, microcontroller.kicad_sch, power.kicad_sch]
2026-07-19 draft v1 release
    [P0004-PCB-001.kicad_pcb, P0004-PCB-001.kicad_sch, ethernet.kicad_sch, microcontroller.kicad_sch, power.kicad_sch]
